danheeks/vario/BMP280Tiny/BMP280Tiny.kicad_pcb

## KiCad design BMP280Tiny/BMP280Tiny.kicad_pcb (2024-12-05)

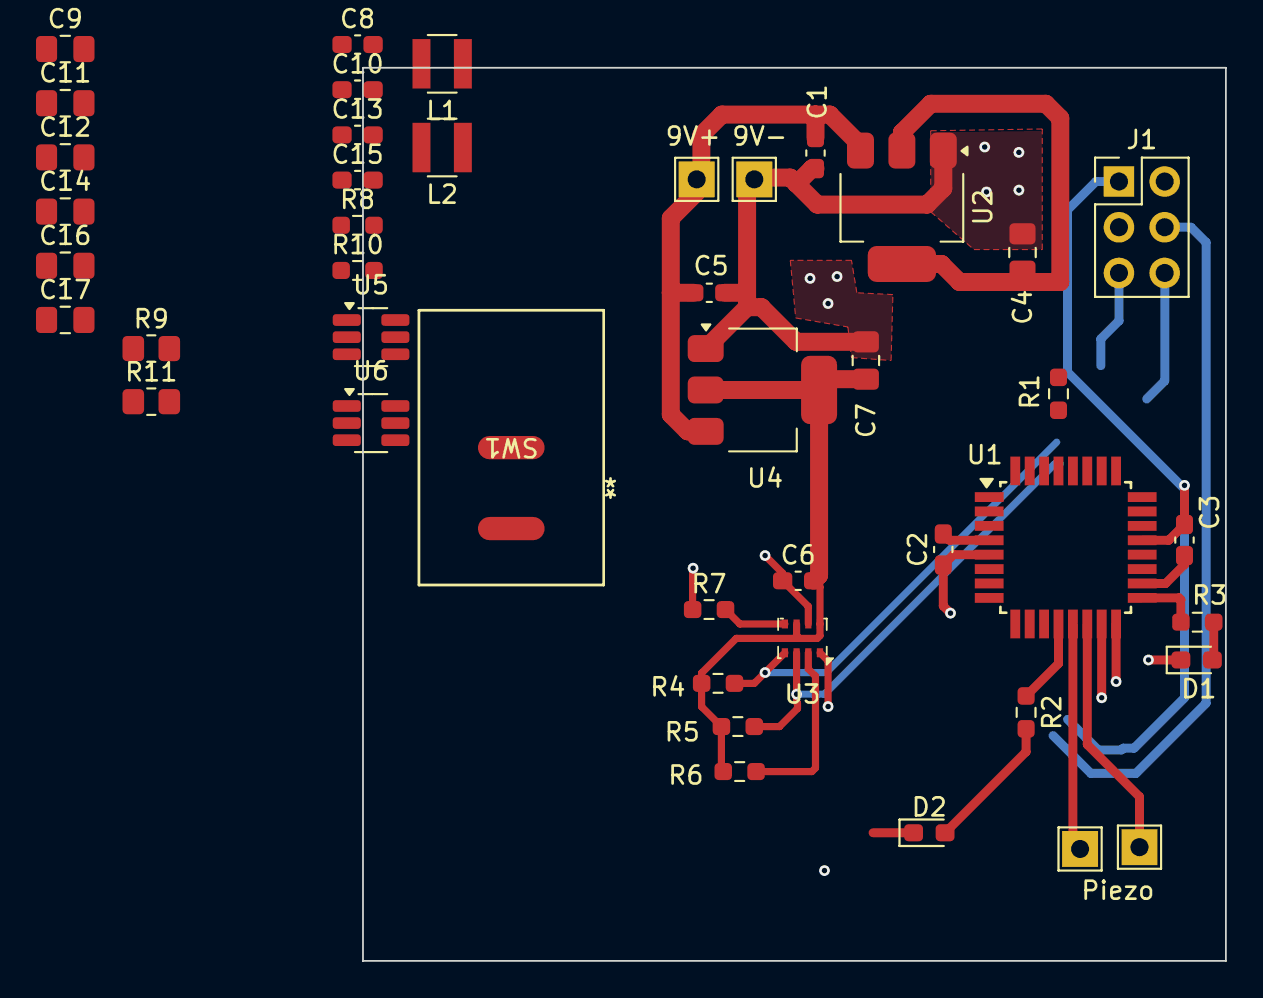
[picture p3: board BMP280Tiny.kicad_pcb from above]

Board: 2 copper layers, 47.9 x 49.6 mm, 44 parts (0 on the bottom side), 26 nets.

Parts:
C1, C2, C3, C5, C6, C10, C15: 0.1uF; C_0603_1608Metric_Pad1.08x0.95mm_HandSolder
C4, C7, C11, C12, C16, C17: 22uF 16V X5R; C_0805_2012Metric_Pad1.18x1.45mm_HandSolder
C8, C13: 10nF; C_0603_1608Metric_Pad1.08x0.95mm_HandSolder
C9, C14: 2.2uF 50V X5R; C_0805_2012Metric_Pad1.18x1.45mm_HandSolder
D1, D2: LED; LED_0603_1608Metric_Pad1.05x0.95mm_HandSolder
H1: 9V+; TestPoint_THTPad_2.0x2.0mm_Drill1.0mm
H2: 9V-; TestPoint_THTPad_2.0x2.0mm_Drill1.0mm
H3, H4: Piezo; TestPoint_THTPad_2.0x2.0mm_Drill1.0mm
J1: Programming Port; PinHeader_2x03_P2.54mm_Vertical
L1: 6.8uH; L_Abracon_ASPI-0310FS
L2: 5.6uH; L_Abracon_ASPI-0310FS
R1, R2, R3, R4, R5, R6, R7: 10k; R_0603_1608Metric_Pad0.98x0.95mm_HandSolder
R8, R10: 100k; R_0603_1608Metric_Pad0.98x0.95mm_HandSolder
R9: 13.7k; R_0805_2012Metric_Pad1.20x1.40mm_HandSolder
R11: 22.1k; R_0805_2012Metric_Pad1.20x1.40mm_HandSolder
SW1: SW_DPST_x2; SW_19x12
U1: ATtiny88-A; TQFP-32_7x7mm_P0.8mm
U2: AMS1117-5.0; SOT-223-3_TabPin2
U3: BMP280; Bosch_LGA-8_2x2.5mm_P0.65mm_ClockwisePinNumbering
U4: AMS1117-3.3; SOT-223-3_TabPin2
U5, U6: LMR51430; SOT-23-6_Handsoldering

Connections:
3.3V: C6.2, C16.1, C17.1, L2.2, R4.2, R5.2, R6.2, R10.1, U3.6 (VDDIO), U3.8 (VDD)
5V: C2.2, C3.2, C4.1, C11.1, C12.1, J1.2, L1.2, R1.1, R8.1, U1.4 (VCC), U1.18 (AVCC), U2.2 (VO)
GND: C1.1, C2.1, C3.1, C4.2, C5.1, C6.1, C7.2, C8.2, C9.2, C11.2, C12.2, C13.2, C14.2, C16.2, C17.2, D1.1 (K), D2.1 (K), H2.1, J1.6, R7.1, R9.2, R11.2, U1.5 (GND), U1.21 (GND), U2.1 (GND), U3.1 (GND), U3.7 (GND), U4.1 (GND), U5.1 (GND), U6.1 (GND)
unnamed: D1.2 (A), R3.1
unnamed: D2.2 (A), R2.2
unnamed: J1.1, U1.16 (PB4)
unnamed: J1.3, R3.2, U1.17 (PB5)
unnamed: J1.4, U1.15 (PB3)
unnamed: J1.5, R1.2, U1.29 (~RESET/PC6)
unnamed: C8.1, C9.1, C13.1, C14.1, SW1.2 (B), U5.3 (VIN), U5.5 (EN), U6.3 (VIN), U6.5 (EN)
unnamed: R2.1, U1.12 (PB0)
unnamed: H3.1, U1.13 (PB1)
unnamed: H4.1, U1.14 (PB2)
unnamed: R4.1, U1.28 (SCL/PC5), U3.4 (SCK)
unnamed: R5.1, U1.27 (SDA/PC4), U3.3 (SDI)
unnamed: C1.2, C5.2, U2.3 (VI), U4.3 (VI)
unnamed: R6.1, U3.2 (CSB)
unnamed: R7.2, U3.5 (SDO)
unnamed: C7.1, U4.2 (VO)
unnamed: C10.1, U5.6 (CB)
unnamed: R8.2, R9.1, U5.4 (FB)
unnamed: C10.2, L1.1, U5.2 (SW)
unnamed: C15.1, U6.6 (CB)
unnamed: R10.2, R11.1, U6.4 (FB)
unnamed: C15.2, L2.1, U6.2 (SW)
VIN: H1.1, SW1.1 (A)
